a-rilley/3_DOF_Robotic_Arm/Armature Inductance/Armature Inductance Waveforms.png

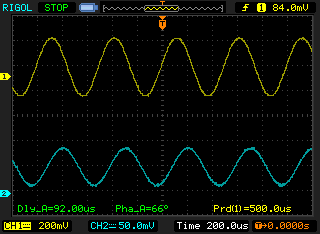
Armature Inductance/Armature Inductance Waveforms.png
