a-rilley/3_DOF_Robotic_Arm/Armature Inductance/Inductance Waveforms.png

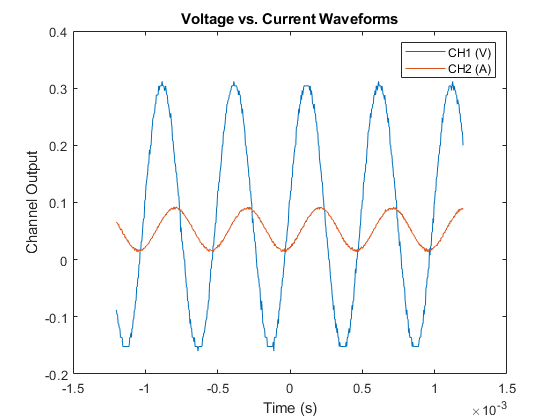
Armature Inductance/Inductance Waveforms.png
