a-rilley/3_DOF_Robotic_Arm/Photos/Original.png

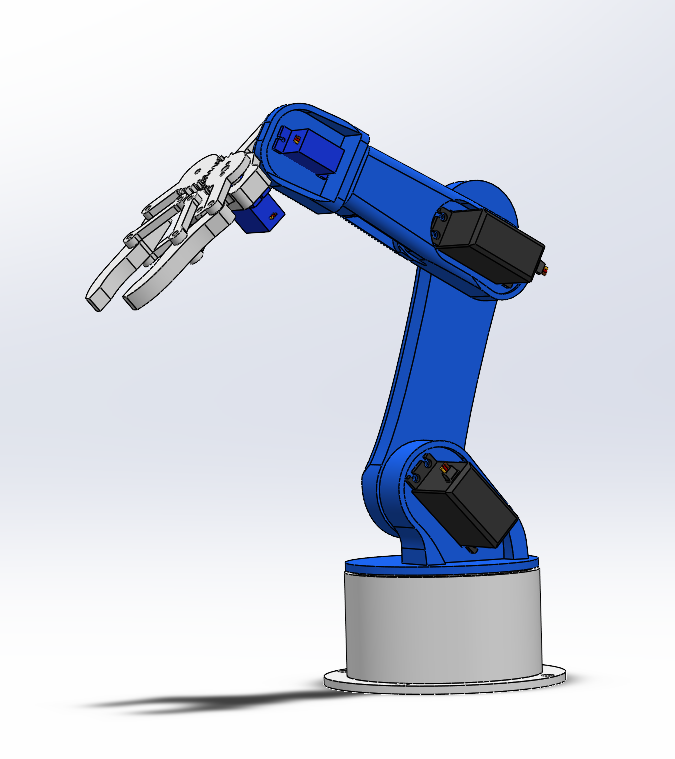
Photos/Original.png
