a-rilley/3_DOF_Robotic_Arm/Simulink Blocks/Simulink Model-Fwd Kin Block-Y.png

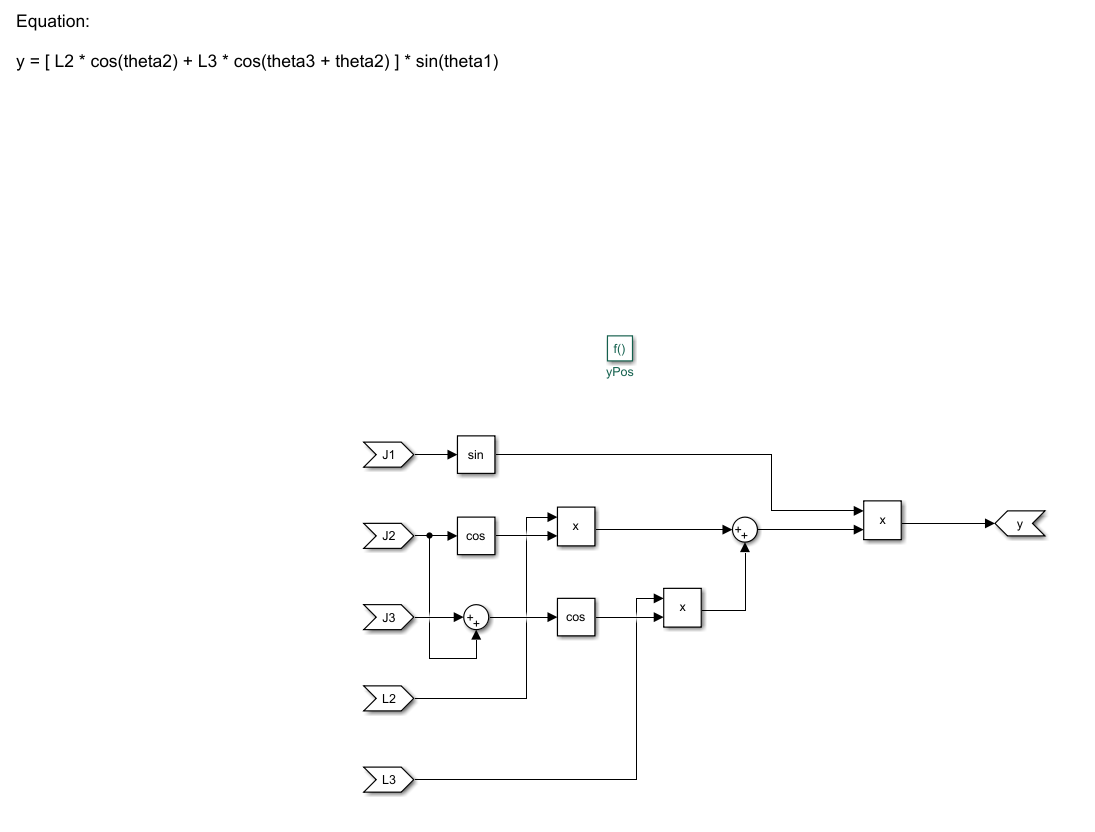
Simulink Blocks/Simulink Model-Fwd Kin Block-Y.png
