a-rilley/3_DOF_Robotic_Arm/Simulink Blocks/Simulink Model-Inv Kin Block-c3.png

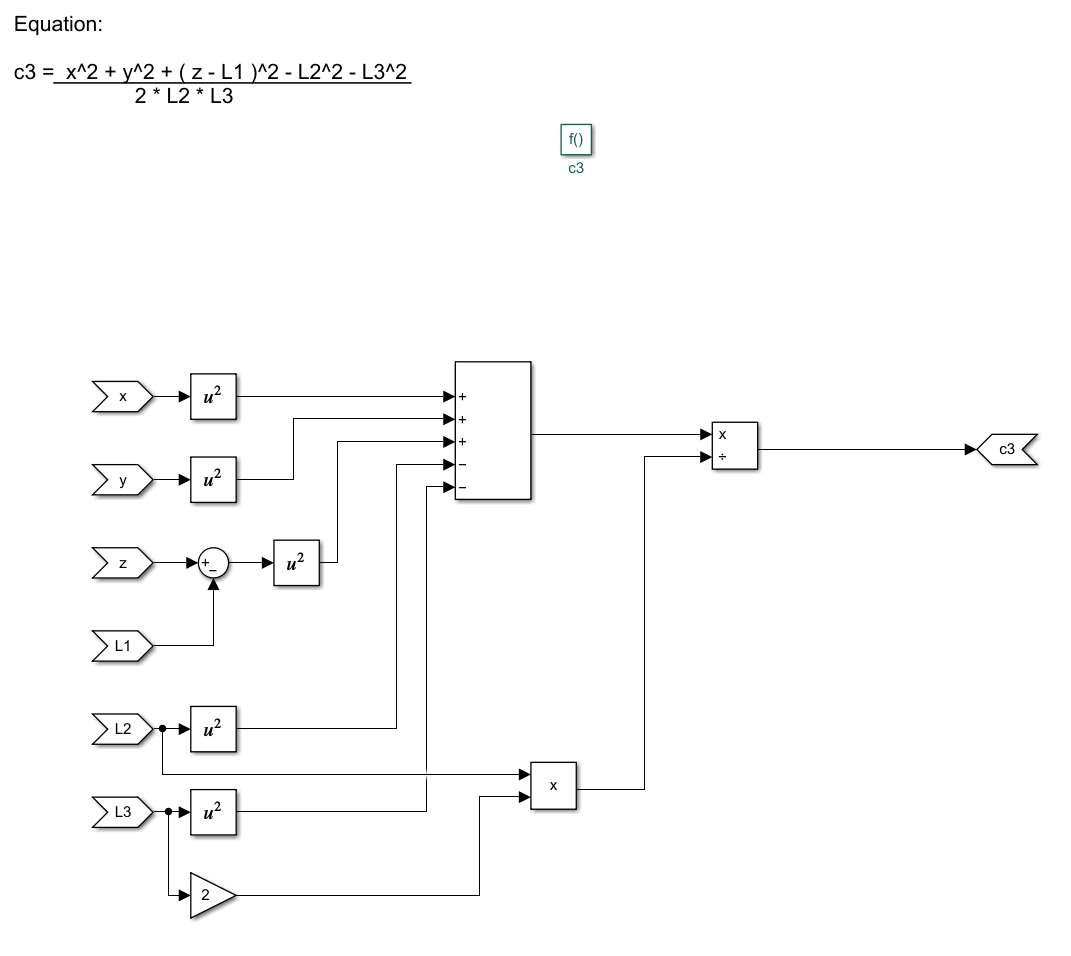
Simulink Blocks/Simulink Model-Inv Kin Block-c3.png
